MOSH-Insa-Toulouse/2025-2026-4GP-SOLE-JANKOWSKI/Images/circuiut_aplificateur.png

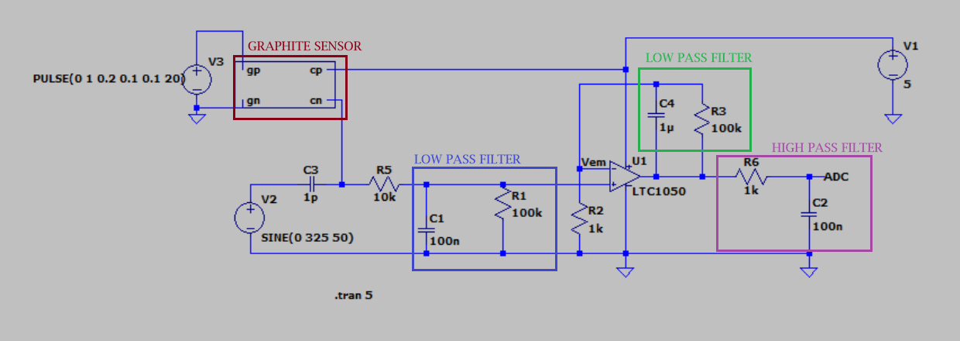
Images/circuiut_aplificateur.png
