MOSH-Insa-Toulouse/2025-2026-4GP-SOLE-JANKOWSKI/Images/oled_digipot.jpg

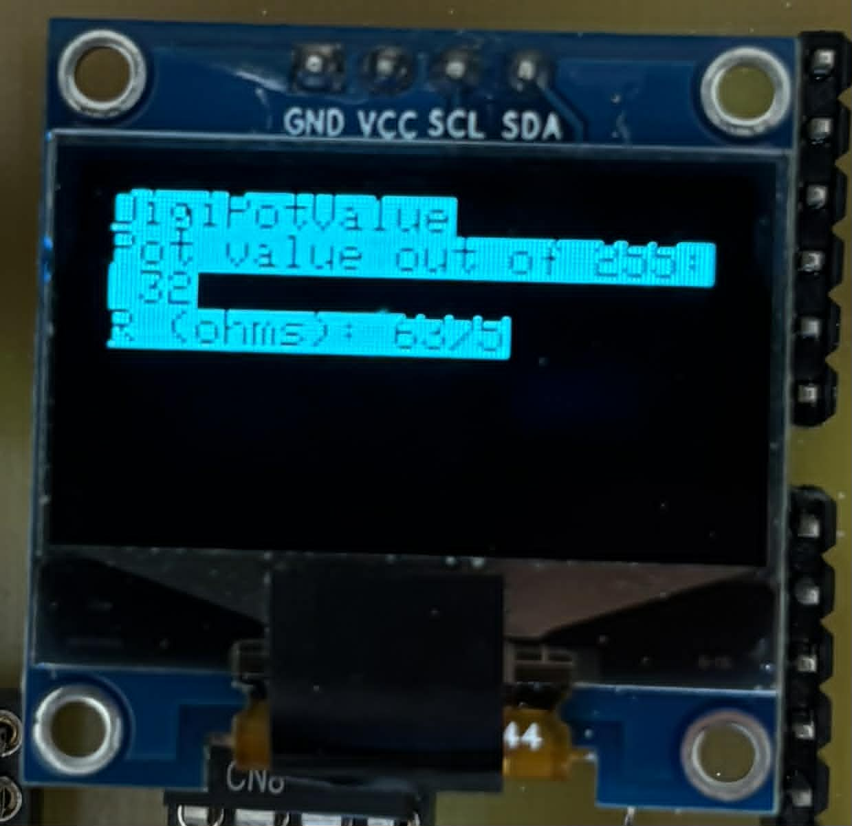
Images/oled_digipot.jpg
