MOSH-Insa-Toulouse/2025-2026-4GP-SOLE-JANKOWSKI/Images/oled_modes_flex.jpg

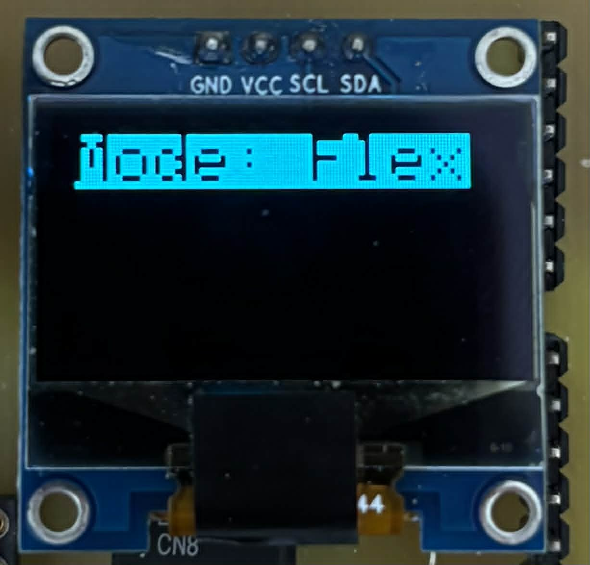
Images/oled_modes_flex.jpg
