MOSH-Insa-Toulouse/2025-2026-4GP-SOLE-JANKOWSKI/Images/ss_circuit_amplifier.png

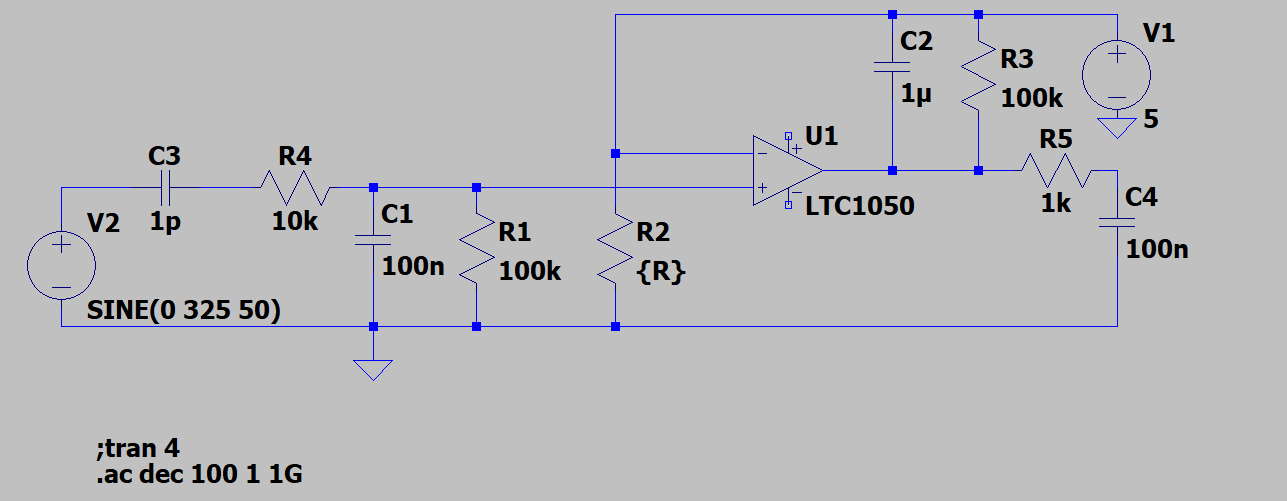
Images/ss_circuit_amplifier.png
