MOSH-Insa-Toulouse/2025-2026-4GP-SOLE-JANKOWSKI/Images/ss_circuit_amplifier_2.png

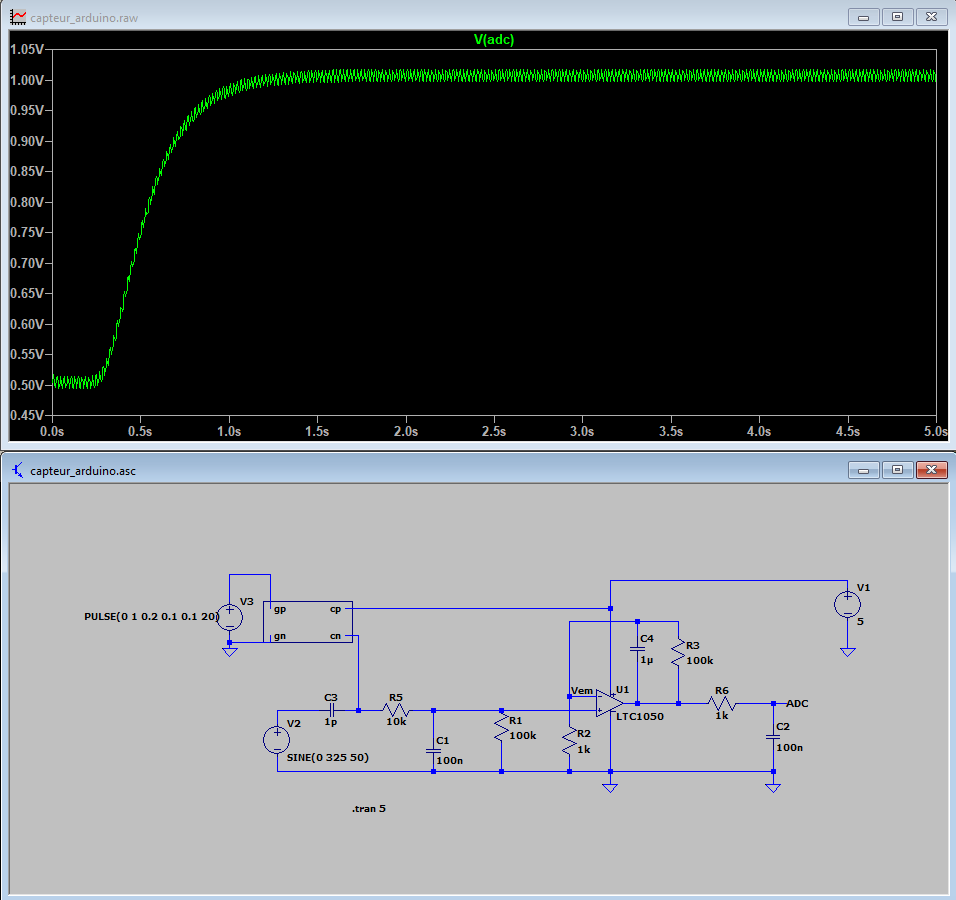
Images/ss_circuit_amplifier_2.png
