MOSH-Insa-Toulouse/2025-2026-4GP-SOLE-JANKOWSKI/LTSpice/AMPLIF.asc

C1: cap; 100n
C2: cap; 1µ
C3: cap; 1p
C4: cap; 100n
R1: res; 100k
R2: res; {R}
R3: res; 100k
R4: res; 10k
R5: res; 1k
U1: LTC1050
V1: voltage; 5
V2: voltage; SINE(0 325 50)
Named nets: 0
;tran 4
.ac dec 100 1 1G
