MOSH-Insa-Toulouse/2025-2026-4GP-SOLE-JANKOWSKI/LTSpice/capteur_arduino.asc

C1: cap; 100n
C2: cap; 100n
C3: cap; 1p
C4: cap; 1µ
C5: cap; 100n
R1: res; 100k
R2: res; 50k
R3: res; 100k
R5: res; 10k
R6: res; 1k
U1: LTC1050
V1: voltage; 5
V2: voltage; SINE(0 325 50)
V3: voltage; PULSE(50n 100n 1 0.1 0.1 2); AC 1 0
X2: capteur_graP_A
Named nets: 0, ADC, Vem
;tran 4
.ac dec 100 1 1G
