MOSH-Insa-Toulouse/2025-2026-4GP-SOLE-JANKOWSKI/KiCad/print_maks_for_shield.png

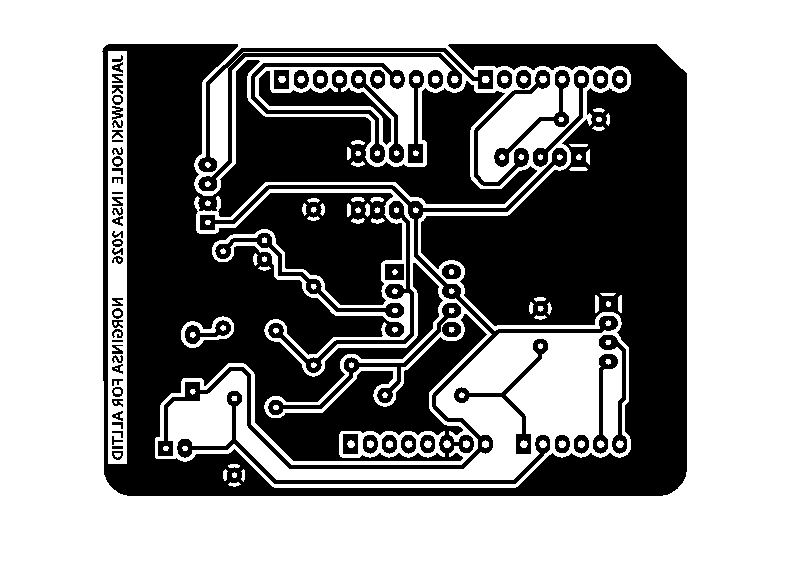
KiCad/print_maks_for_shield.png
