MOSH-Insa-Toulouse/2025-2026-4GP-SOLE-JANKOWSKI/Arduino Code/QR.cpp

/*
  QR.h -Library which contains the binary strucutre for a QR.png that links to the Github page of the developers
  Created by Wiktor Jankowski and Jaon Solé, on April 9, 2026 
*/

#include "Arduino.h"
#include "QR.h"

// 'QR_code_github', 128x64px
const unsigned char epd_bitmap_QR_code_github [] PROGMEM = {
  0xff, 0xff, 0xff, 0xff, 0xff, 0xff, 0xff, 0xff, 0xff, 0xff, 0xff, 0xff, 0xff, 0xff, 0xff, 0xff, 
  0xe0, 0x01, 0x9e, 0x03, 0x0d, 0x87, 0xe0, 0x01, 0xff, 0xff, 0xff, 0xff, 0xff, 0xff, 0xff, 0xff, 
  0xe0, 0x01, 0x9e, 0x03, 0x09, 0x87, 0xc0, 0x01, 0xff, 0xff, 0xff, 0xff, 0xff, 0xff, 0xff, 0xff, 
  0xef, 0xfd, 0xe1, 0xec, 0xc1, 0x80, 0x4f, 0xfd, 0xff, 0xff, 0xff, 0xff, 0xff, 0xff, 0xff, 0xff, 
  0xef, 0xfd, 0xe1, 0xec, 0xc1, 0x80, 0x4f, 0xfd, 0xff, 0xff, 0xff, 0xff, 0xff, 0xff, 0xff, 0xff, 
  0xec, 0x0d, 0xf9, 0x8c, 0xc7, 0x99, 0xcc, 0x0d, 0xff, 0xff, 0xff, 0xff, 0xff, 0xff, 0xff, 0xff, 
  0xec, 0x0d, 0xf9, 0x8c, 0xc7, 0x99, 0xcc, 0x0d, 0xff, 0xff, 0xff, 0xff, 0xff, 0xff, 0xff, 0xff, 
  0xec, 0x0d, 0xff, 0x93, 0xfe, 0x07, 0xcc, 0x0d, 0xff, 0xff, 0xff, 0xff, 0xff, 0xff, 0xff, 0xff, 
  0xec, 0x0d, 0xff, 0xbb, 0xfe, 0x07, 0xcc, 0x0d, 0xff, 0xff, 0xff, 0xff, 0xff, 0xff, 0xff, 0xff, 
  0xec, 0x0d, 0xe6, 0x7c, 0x08, 0x00, 0x4c, 0x0d, 0xff, 0xff, 0xff, 0xff, 0xff, 0xff, 0xff, 0xff, 
  0xee, 0x1d, 0xe6, 0x7c, 0x08, 0x00, 0x4e, 0x1d, 0xff, 0xff, 0xff, 0xff, 0xff, 0xff, 0xff, 0xff, 
  0xef, 0xfd, 0xf9, 0x90, 0x36, 0x1e, 0x4f, 0xfd, 0xff, 0xff, 0xff, 0xff, 0xff, 0xff, 0xff, 0xff, 
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
  ecranOLED.clearDisplay();

  // Draw bitmap (128x64 full screen)
  ecranOLED.drawBitmap(
    0, 0,
    epd_bitmap_QR_code_github,
    128, 64,
    SSD1306_BLACK
  );

  ecranOLED.display();

  // Wait for button to go back
  while (digitalRead(Switch) != LOW);
  delay(200);
}
