MOSH-Insa-Toulouse/2025-2026-4GP-SOLE-JANKOWSKI/(commit log)

2026-04-07 Fix section title and add circuit simulation details
    Corrected the section title and added a description about the circuit simulations.
2026-04-07 Clarify LTSpice section and update link
    Updated the README to clarify the section on LTSpice simulations and corrected the link for circuit simulations.
2026-04-12 missing flex measurements and bluetooth
    [main_code.ino]
2026-04-16 adding LTSpice depository and KiCad depository
